UCSD-Quadcopter-Class/quad-hardware-connie/PartList.xlsx

Description | DATASHEET | DIST | DISTPN | MFR | MPN | VALUE | Lab02
Light emitting diode | http://media.digikey.com/pdf/Data%20Sheets/Lite-On%20PDFs/LTST-C170EKT.pdf | Digikey | 160-1178-1-ND | Lite-On Inc | LTST-C170EKT | red | you build
Light emitting diode | http://media.digikey.com/pdf/Data%20Sheets/Lite-On%20PDFs/LTST-C170GKT.pdf | Digikey | 160-1179-1-ND | Lite-On Inc | LTST-C170GKT | green
0805 0Ohm resistor | http://media.digikey.com/pdf/Data%20Sheets/Yageo%20PDFs/RC0805%20Pb%20Free.pdf | Digikey | 311-0.0ARCT-ND | Yageo | RC0805JR-070RL | 0 | you build
0805 100Ohm resistor | http://media.digikey.com/pdf/Data%20Sheets/Yageo%20PDFs/RC0805%20Pb%20Free.pdf | Digikey | 311-100ARCT-ND | Yageo | RC0805JR-07100RL | 100
0805 10KOhm resistor | http://media.digikey.com/pdf/Data%20Sheets/Yageo%20PDFs/RC0805%20Pb%20Free.pdf | Digikey | 311-10KARCT-ND | Yageo | RC0805JR-0710KL | 10K
0805 330Ohm resistor | http://media.digikey.com/pdf/Data%20Sheets/Yageo%20PDFs/RC0805%20Pb%20Free.pdf | Digikey | 311-330ARCT-ND | Yageo | RC0805JR-07330RL | 330
0805 5.1KOhm resistor | http://media.digikey.com/pdf/Data%20Sheets/Yageo%20PDFs/RC0805%20Pb%20Free.pdf | Digikey | 311-5.1KARCT-ND | Yageo | RC0805JR-075K1L | 5.1K
2x1 0.1" male header | http://multimedia.3m.com/mws/mediawebserver?66666UuZjcFSLXTtNxTElX&VEVuQEcuZgVs6EVs6E666666-- | Digikey | 3M9447-ND | 3M | 961102-6404-AR |  | Provided
Tactile buttons | http://www.te.com/commerce/DocumentDelivery/DDEController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 | Digikey | 450-1759-1-ND | TE Connectivity Alcoswitch Switches | FSM4JSMA
100uF Tantalum Capacitor | http://datasheets.avx.com/TAJ.pdf | Digikey | 478-1677-1-ND | AVX Corporation | TAJB107K006RNJ | 100uF
220uF Tantalum Capacitor | http://datasheets.avx.com/TAJ.pdf | Digikey | 478-8912-1-ND | AVX Corporation | TAJD227K006RNJ | 220uF
0.1uF Ceramic Capacitor | http://www.murata.com/~/media/webrenewal/support/library/catalog/products/capacitor/mlcc/c02e.ashx | Digikey | 490-1666-1-ND | Murata Electronics North America | GRM21BR71H104KA01L | 0.1uF | Provided
0.22uF Ceramic Capacitor | http://www.murata.com/~/media/webrenewal/support/library/catalog/products/capacitor/mlcc/c02e.ashx | Digikey | 490-1670-1-ND | Murata Electronics North America | GRM21BR71H224KA01L | 0.22uF
4.7uF Ceramic Capacitor | http://www.murata.com/~/media/webrenewal/support/library/catalog/products/capacitor/mlcc/c02e.ashx | Digikey | 490-3335-1-ND | Murata Electronics North America | GRM21BR61E475KA12L | 4.7uF
0.75pF Ceramic Capacitor | http://search.murata.co.jp/Ceramy/image/img/A01X/G101/ENG/GQM2195C2AR75CB01-01.pdf | Digikey | 490-3585-1-ND | Murata Electronics North America | GQM2195C2AR75CB01D | 0.75pF
1uF Ceramic Capacitor | http://www.murata.com/~/media/webrenewal/support/library/catalog/products/capacitor/mlcc/c02e.ashx | Digikey | 490-4736-1-ND | Murata Electronics North America | GRM21BR71H105KA12L | 1uF
10uF Ceramic Capacitor | http://www.murata.com/~/media/webrenewal/support/library/catalog/products/capacitor/mlcc/c02e.ashx | Digikey | 490-5523-1-ND | Murata Electronics North America | GRM21BR61E106KA73L | 10uF
12pF Ceramic Capacitor | http://www.murata.com/~/media/webrenewal/support/library/catalog/products/capacitor/mlcc/c02e.ashx | Digikey | 490-5531-1-ND | Murata Electronics North America | GRM21A5C2E120JW01D | 12pF
22pF Ceramic Capacitor | http://www.murata.com/~/media/webrenewal/support/library/catalog/products/capacitor/mlcc/c02e.ashx | Digikey | 490-5534-1-ND | Murata Electronics North America | GRM21A5C2E220JW01D | 22pF
0.01uF Ceramic Capacitor | http://www.murata.com/~/media/webrenewal/support/library/catalog/products/capacitor/mlcc/c02e.ashx | Digikey | 490-8295-1-ND | Murata Electronics North America | GRM2195C1H103FA01D | 0.01uF
LSM9DS1TR 9-Axis IMU | http://www.st.com/content/ccc/resource/technical/document/datasheet/1e/3f/2a/d6/25/eb/48/46/DM00103319.pdf/files/DM00103319.pdf/jcr:content/translations/en.DM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 | Digikey | 497-14946-1-ND | STMicroelectronics | LSM9DS1TR |  | you build
12pF Ceramic Capacitor | http://www.abracon.com/Resonators/abm3b.pdf | Digikey | 535-9122-1-ND | Abracon LLC | ABM3B-16.000MHZ-B2-T
2x3 0.1" male header | http://portal.fciconnect.com/Comergent//fci/drawing/67996.pdf | Digikey | 609-3234-ND | Amphenol FCI | 67997-206HLF
1x10 0.1" pin male header | http://portal.fciconnect.com/Comergent//fci/drawing/68000.pdf | Digikey | 609-3250-ND | Amphenol FCI | 68000-110HLF
1x6 0.1" right handle male header | http://portal.fciconnect.com/Comergent//fci/drawing/68015.pdf | Digikey | 609-3327-ND | Amphenol FCI | 68016-406HLF
0805 Balun | http://katalog.we-online.de/pbs/datasheet/748421245.pdf | Digikey | 732-2230-6-ND | Wurth Electronics Inc | 748421245
Chip antenna | http://www.linxtechnologies.com/resources/data-guides/ant-xxx-chp-x.pdf | Digikey | ANT-2.45-CHPCT-ND | Linx Technologies Inc. | ANT-2.45-CHP-T
ATmega128RFA1 Microcontroller | http://www.atmel.com/Images/Atmel-8266-MCU_Wireless-ATmega128RFA1_Datasheet.pdf | Digikey | ATMEGA128RFA1-ZU00-ND | Atmel | ATMEGA128RFA1-ZUR00
SOD-123 Schottky diode | http://toshiba.semicon-storage.com/info/docget.jsp?did=3168&prodName=CRS08 | Digikey | CRS08QMCT-ND | Toshiba Semiconductor and Storage | CRS08(TE85L,Q,M) | 360mV
3.0V Voltage Regulator | http://www.ti.com/lit/ds/symlink/lp3985.pdf | Digikey | LP3985IM5X-3.0/NOPBCT-ND | Texas Instruments | LP3985IM5X-3.0/NOPB
N-Channel MOSFET | http://www.vishay.com/docs/68645/si2302cds.pdf | Digikey | SI2302CDS-T1-E3CT-ND | Vishay Siliconix | SI2302CDS-T1-E3 | 2.6A | you build
Battery holder | See replacement body in crash kit
Motor connector | 2 SMDs (one negative, one positive) 2-3mm on a side 2 mm between them.
