UCSD-Quadcopter-Class/quad-hardware-connie/quadcopter.brd

## EAGLE design quadcopter.brd (2017-05-19)

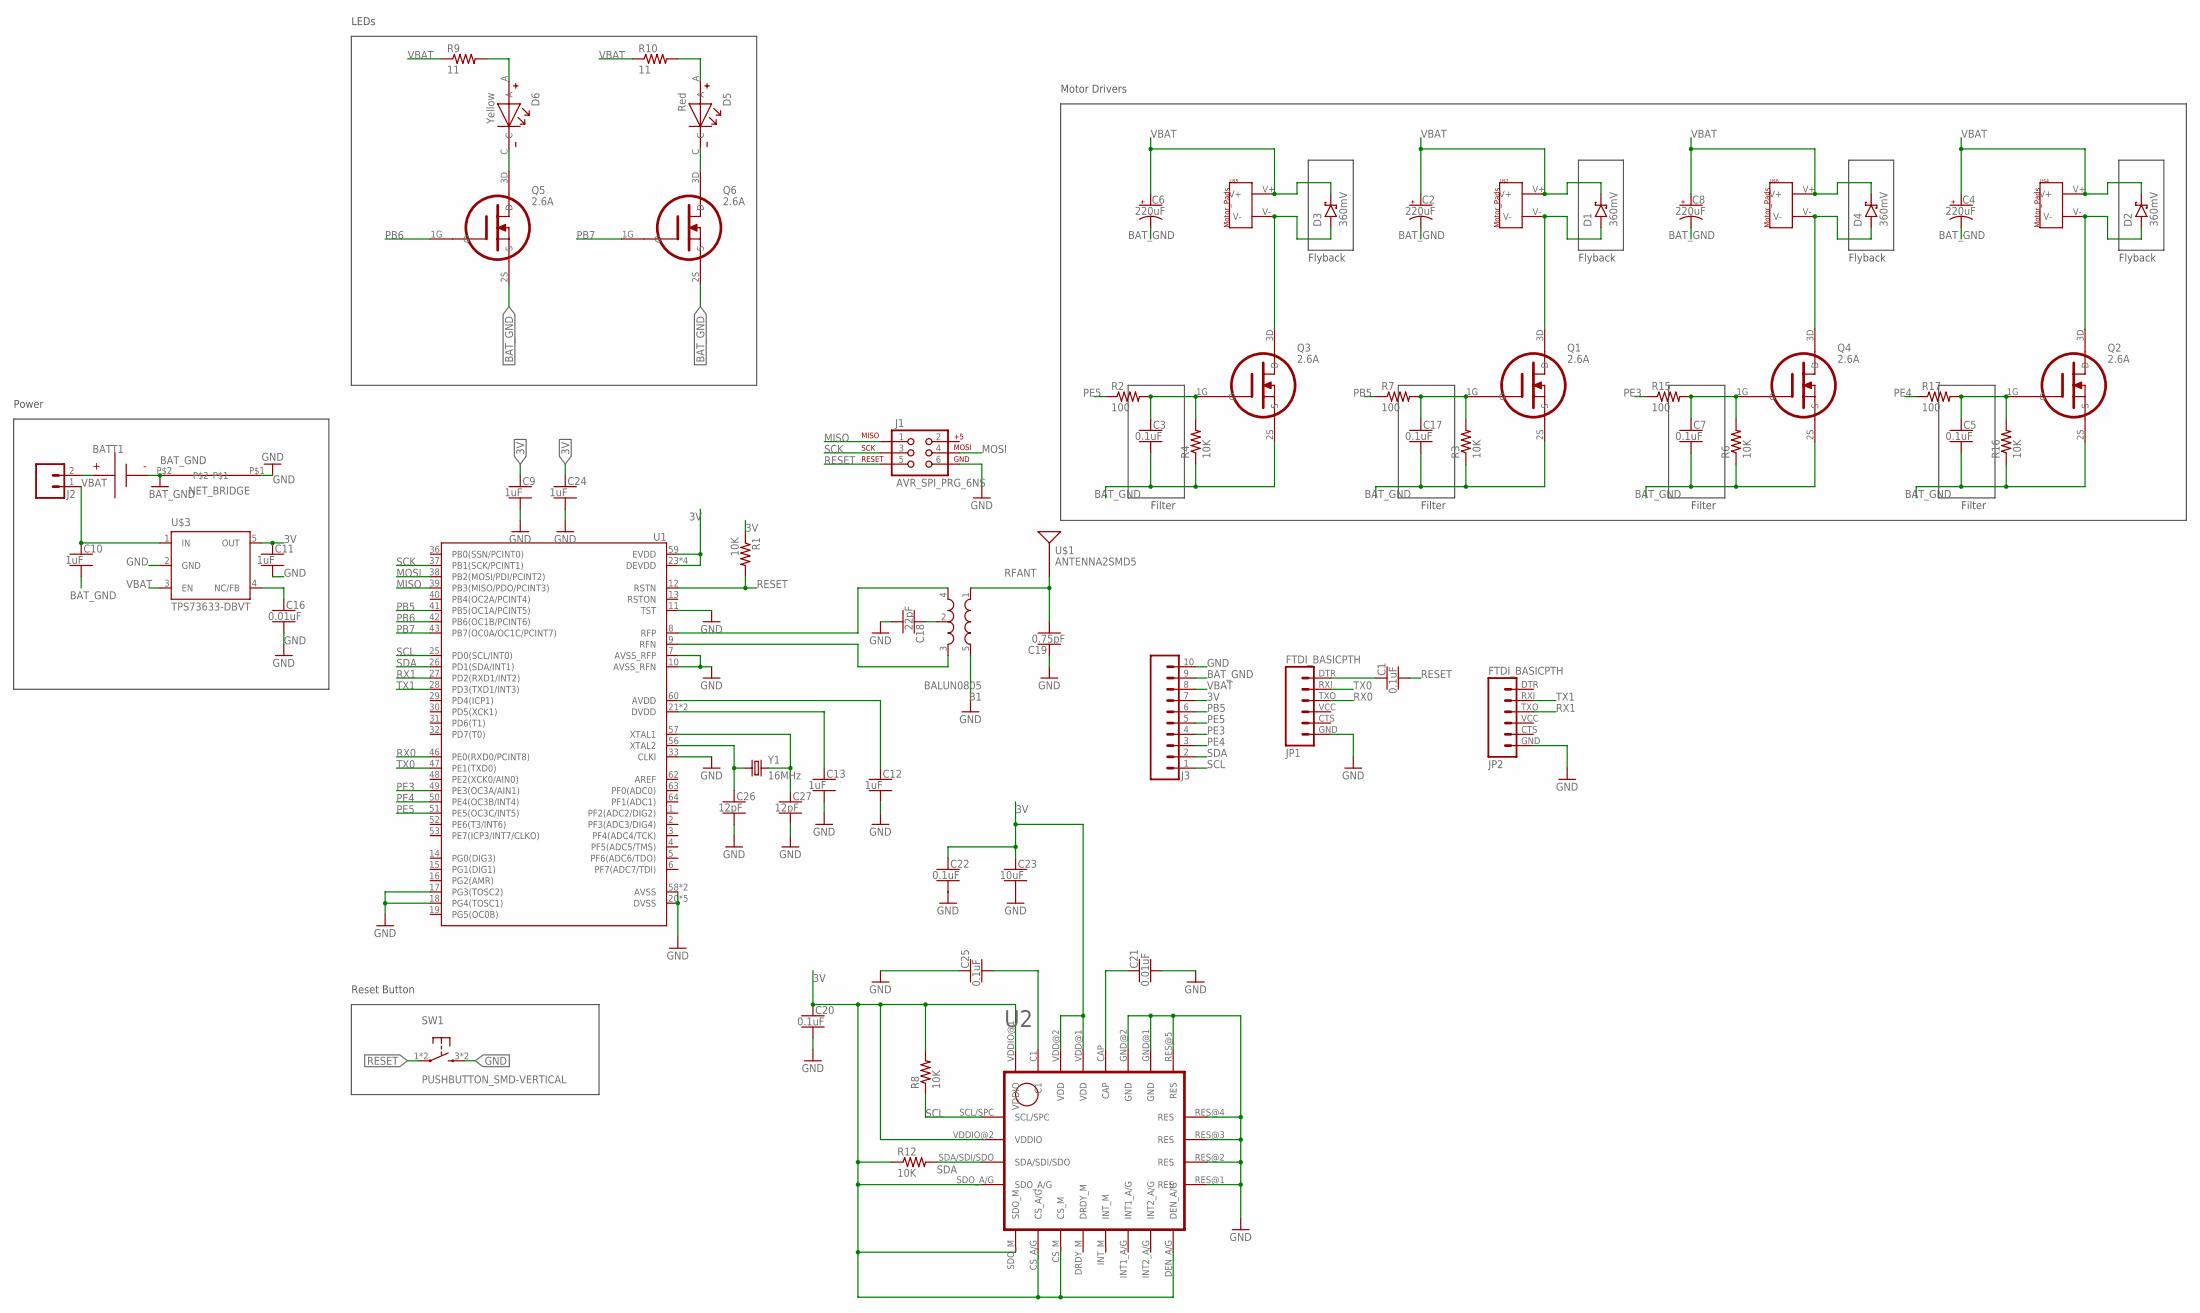
[picture p1: schematic quadcopter.sch]

Parts:
B1: BALUN0805; BALUN
BATT1: BATTERY-HUBSAN-W/HOLDER; BATTERY-W/HOLDER-380MAH-HUBSAN
C1: 0.1uF; CERAMIC_CAP_0805
C2, C4, C6, C8: 220uF; CAPMP7343X310_HS
C3, C5, C7, C17, C20, C22, C25: 0.1uF; CAPC2012X140_HS
C9, C10, C11, C12, C13, C24: 1uF; CAPC2012X140_HS
C16, C21: 0.01uF; CAPC2012X140_HS
C18: 22pF; CAPC2012X140_HS
C19: 0.75pF; CAPC2012X140_HS
C23: 10uF; CAPC2012X140_HS
C26, C27: 12pF; CAPC2012X140_HS
D1, D2, D3, D4: 360mV; SOD3716X135_HS
D5: Red; LED_VLMX51Z1AA
D6: Yellow; LED_VLMX51Z1AA
J1: AVR_SPI_PRG_6NS; 2X3-NS
J2: MALE_HEADER_2POS-2X1-0.1IN; MALE_HEADER_2X1_0.1IN
J3: SIP-10_TH-254X10; HDRV10W63P254_10X1_2540X254H838_HS
JP1, JP2: FTDI_BASICPTH; FTDI_BASIC
NET_BRIDGE: NET_BRIDGE
Q1, Q2, Q3, Q4, Q5, Q6: 2.6A; N_MOSFET_SI2302CDS_T1_E3
R1, R3, R4, R6, R8, R12, R16: 10K; RESC2012X60_HS
R2, R7, R15, R17: 100; RESC2012X60_HS
R9, R10: 11; RESC2012X60_HS
SW1: PUSHBUTTON_SMD-VERTICAL; TE_FSM8JSMA_HS
U1: ATMEGA128RFA1; QFN-64
U2: IMU_LSM9DS1TR
U$1: ANTENNA2SMD5; ANTENNA-CHIP5
U$2, U$4, U$5, U$6: MOTOR_PADS
U$3: TPS73633-DBVT; SOT23-DBV
Y1: 16MHz; CRYSTAL-SMD-5X3

Connections:
3V: C9.1, C11.1, C20.1, C22.1, C23.1, C24.1, J3.7, R1.1, R8.2, R12.1, U1.23 (DEVDD), U1.34 (DEVDD), U1.44 (DEVDD), U1.54 (DEVDD), U1.59 (EVDD), U2.CS_A/G, U2.CS_M, U2.DEN_A/G, U2.SDO_A/G, U2.SDO_M, U2.VDD@1 (VDD), U2.VDD@2 (VDD), U2.VDDIO@1 (VDDIO), U2.VDDIO@2 (VDDIO), U$3.5 (OUT)
BAT_GND: BATT1.- (N), C2.2 (-), C3.2, C4.2 (-), C5.2, C6.2 (-), C7.2, C8.2 (-), C10.2, C17.2, J3.9, NET_BRIDGE.P$2, Q1.2S (S), Q2.2S (S), Q3.2S (S), Q4.2S (S), Q5.2S (S), Q6.2S (S), R3.1, R4.1, R6.1, R16.1
FILTERED: C7.1, Q4.1G (G), R6.2, R15.2
GND: B1.5 (GND), C9.2, C11.2, C12.2, C13.2, C16.2, C18.2, C19.1, C20.2, C21.2, C22.2, C23.2, C24.2, C25.1, C26.2, C27.2, J1.6, J3.10, JP1.GND (6), JP2.GND (6), NET_BRIDGE.P$1, SW1.3 (2), SW1.4 (2), U1.7 (AVSS_RFP), U1.10 (AVSS_RFN), U1.11 (TST), U1.17 (PG3(TOSC2)), U1.18 (PG4(TOSC1)), U1.20 (DVSS), U1.24 (DVSS), U1.33 (CLKI), U1.35 (DVSS), U1.45 (DVSS), U1.55 (DVSS), U1.58 (AVSS), U1.61 (AVSS), U2.GND@1 (GND), U2.GND@2 (GND), U2.RES@1 (RES), U2.RES@2 (RES), U2.RES@3 (RES), U2.RES@4 (RES), U2.RES@5 (RES), U$3.2 (GND)
MISO: J1.1, U1.39 (PB3(MISO/PDO/PCINT3))
MOSI: J1.4, U1.38 (PB2(MOSI/PDI/PCINT2))
unnamed: C1.1, JP1.DTR (1)
unnamed: D6.C, Q5.3D (D)
unnamed: D6.A, R9.2
unnamed: D5.C, Q6.3D (D)
unnamed: C27.1, U1.57 (XTAL1), Y1.3 (2)
unnamed: D5.A, R10.2
unnamed: C12.1, U1.60 (AVDD)
unnamed: C13.1, U1.21 (DVDD), U1.22 (DVDD)
unnamed: C26.1, U1.56 (XTAL2), Y1.1
unnamed: C25.2, U2.C1
unnamed: D1.A, Q1.3D (D), U$2.V-
unnamed: C21.1, U2.CAP
unnamed: B1.4 (OUT1), U1.8 (RFP)
unnamed: B1.3 (OUT2), U1.9 (RFN)
unnamed: BATT1.+, J2.2
unnamed: D3.A, Q3.3D (D), U$5.V-
unnamed: B1.2 (GND), C18.1
unnamed: D4.A, Q4.3D (D), U$6.V-
unnamed: D2.A, Q2.3D (D), U$4.V-
unnamed: C3.1, Q3.1G (G), R2.2, R4.2
unnamed: C16.1, U$3.4 (NC/FB)
unnamed: C17.1, Q1.1G (G), R3.2, R7.2
unnamed: C5.1, Q2.1G (G), R16.2, R17.2
PB5: J3.6, R7.1, U1.41 (PB5(OC1A/PCINT5))
PB6: Q5.1G (G), U1.42 (PB6(OC1B/PCINT6))
PB7: Q6.1G (G), U1.43 (PB7(OC0A/OC1C/PCINT7))
PE3: J3.4, R15.1, U1.49 (PE3(OC3A/AIN1))
PE4: J3.3, R17.1, U1.50 (PE4(OC3B/INT4))
PE5: J3.5, R2.1, U1.51 (PE5(OC3C/INT5))
RESET: C1.2, J1.5, R1.2, SW1.1, SW1.2 (1), U1.12 (RSTN)
RFANT: B1.1 (IN), C19.2, U$1.FEED
RX0: JP1.TXO (3), U1.46 (PE0(RXD0/PCINT8))
RX1: JP2.TXO (3), U1.27 (PD2(RXD1/INT2))
SCK: J1.3, U1.37 (PB1(SCK/PCINT1))
SCL: J3.1, R8.1, U1.25 (PD0(SCL/INT0)), U2.SCL/SPC
SDA: J3.2, R12.2, U1.26 (PD1(SDA/INT1)), U2.SDA/SDI/SDO
TX0: JP1.RXI (2), U1.47 (PE1(TXD0))
TX1: JP2.RXI (2), U1.28 (PD3(TXD1/INT3))
VBAT: C2.1 (+), C4.1 (+), C6.1 (+), C8.1 (+), C10.1, D1.C, D2.C, D3.C, D4.C, J2.1, J3.8, R9.1, R10.1, U$2.V+, U$3.1 (IN), U$3.3 (EN), U$4.V+, U$5.V+, U$6.V+

Notes on the sheet:
Flyback
Filter
Reset Button
LEDs
Motor Drivers
Power

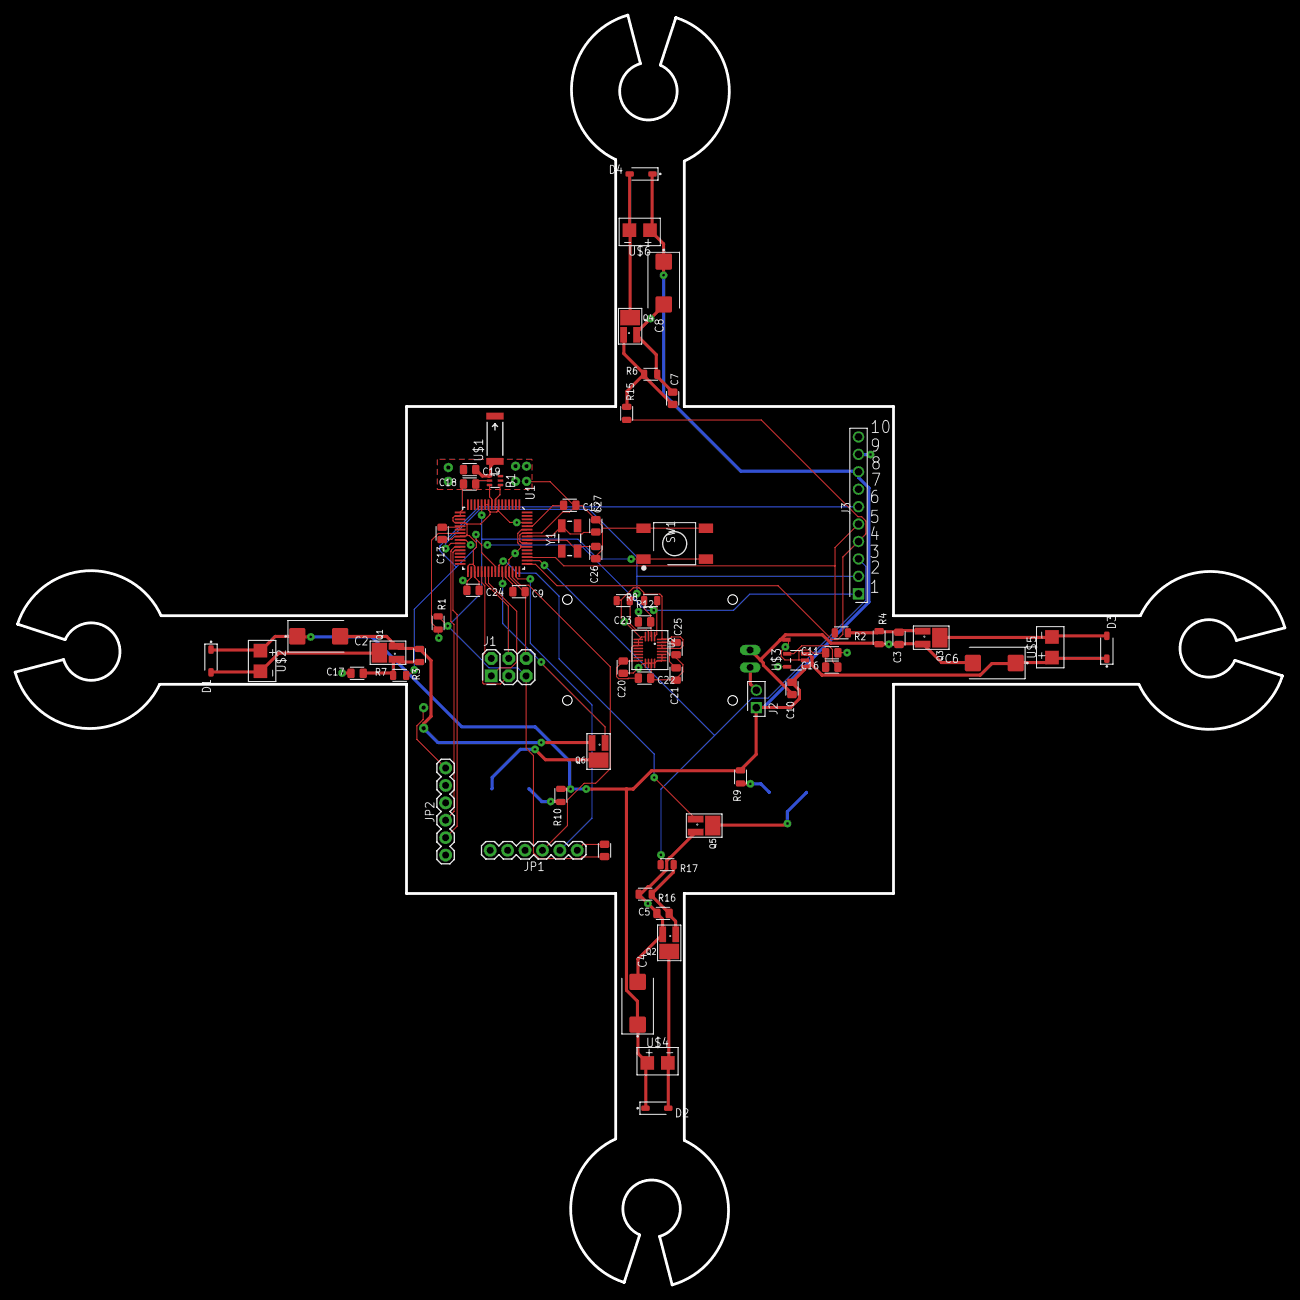
[picture p2: board quadcopter.brd from above]

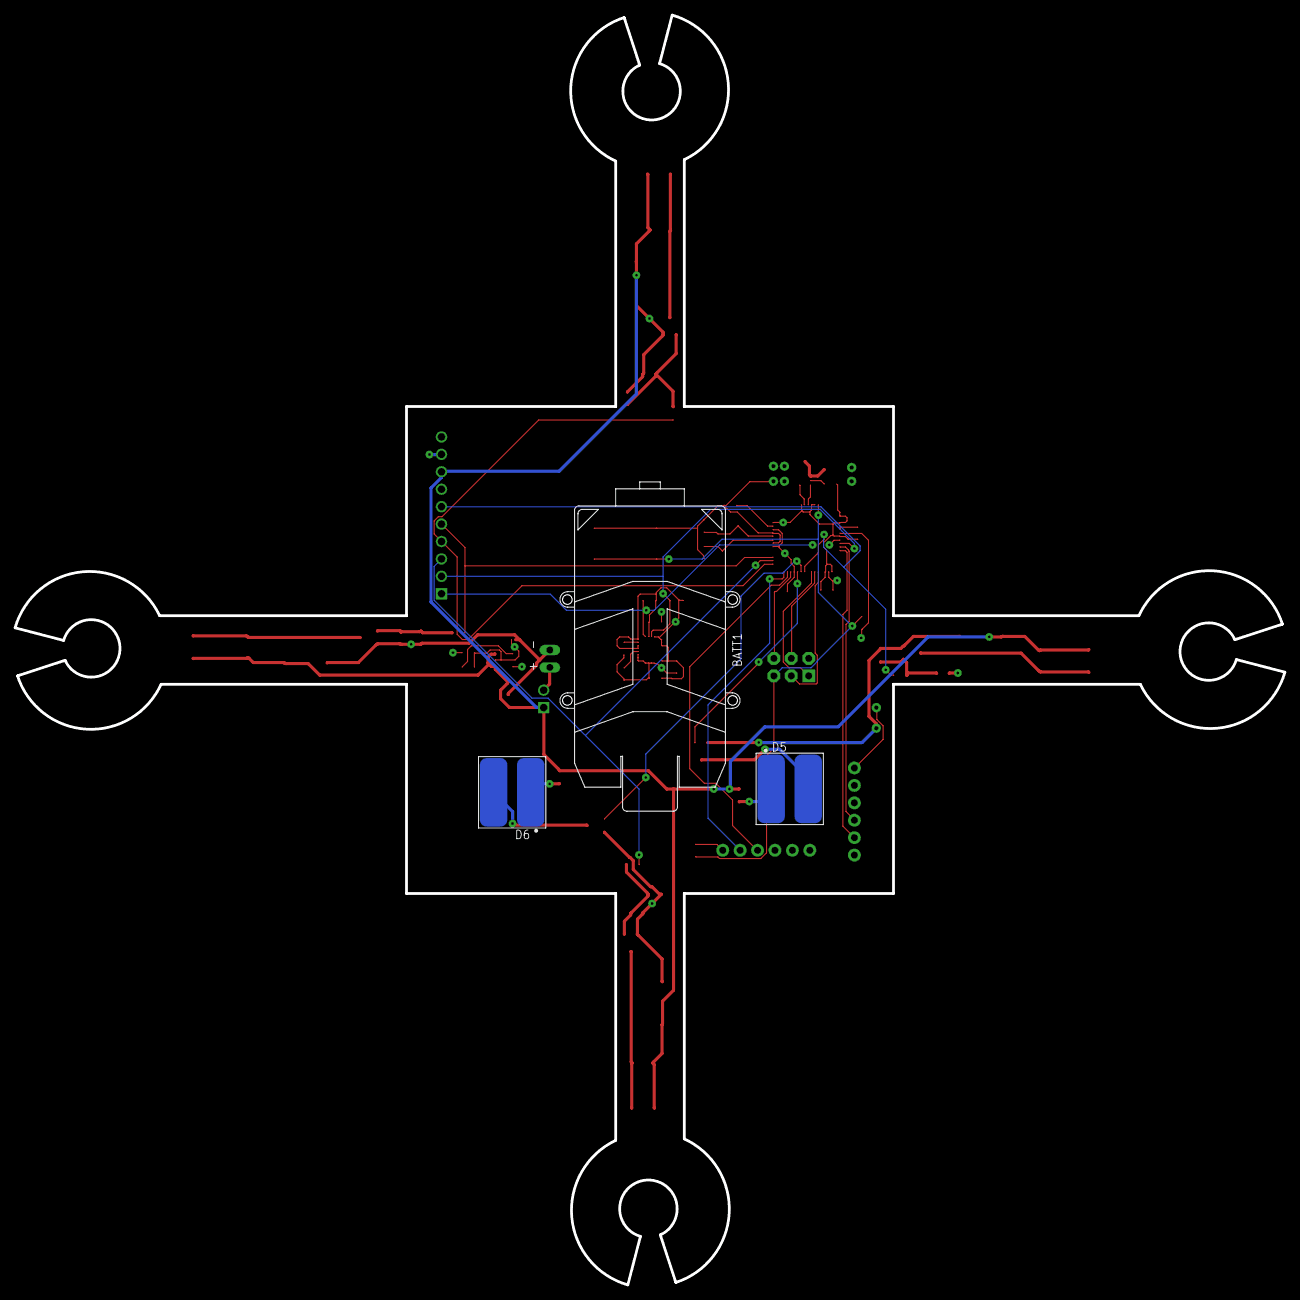
[picture p3: board quadcopter.brd from below]

Board: 4 copper layers, 185.1 x 185.1 mm, 68 parts (3 on the bottom side), 45 nets.
