UCSD-Quadcopter-Class/quad-hardware-connie/ATmega128RFA1_Dev-master/Production Files/ATmega128RFA1-DevBoard-Panel-v23.brd

## EAGLE design ATmega128RFA1_Dev-master/Production Files/ATmega128RFA1-DevBoard-Panel-v23.brd (2017-04-18)

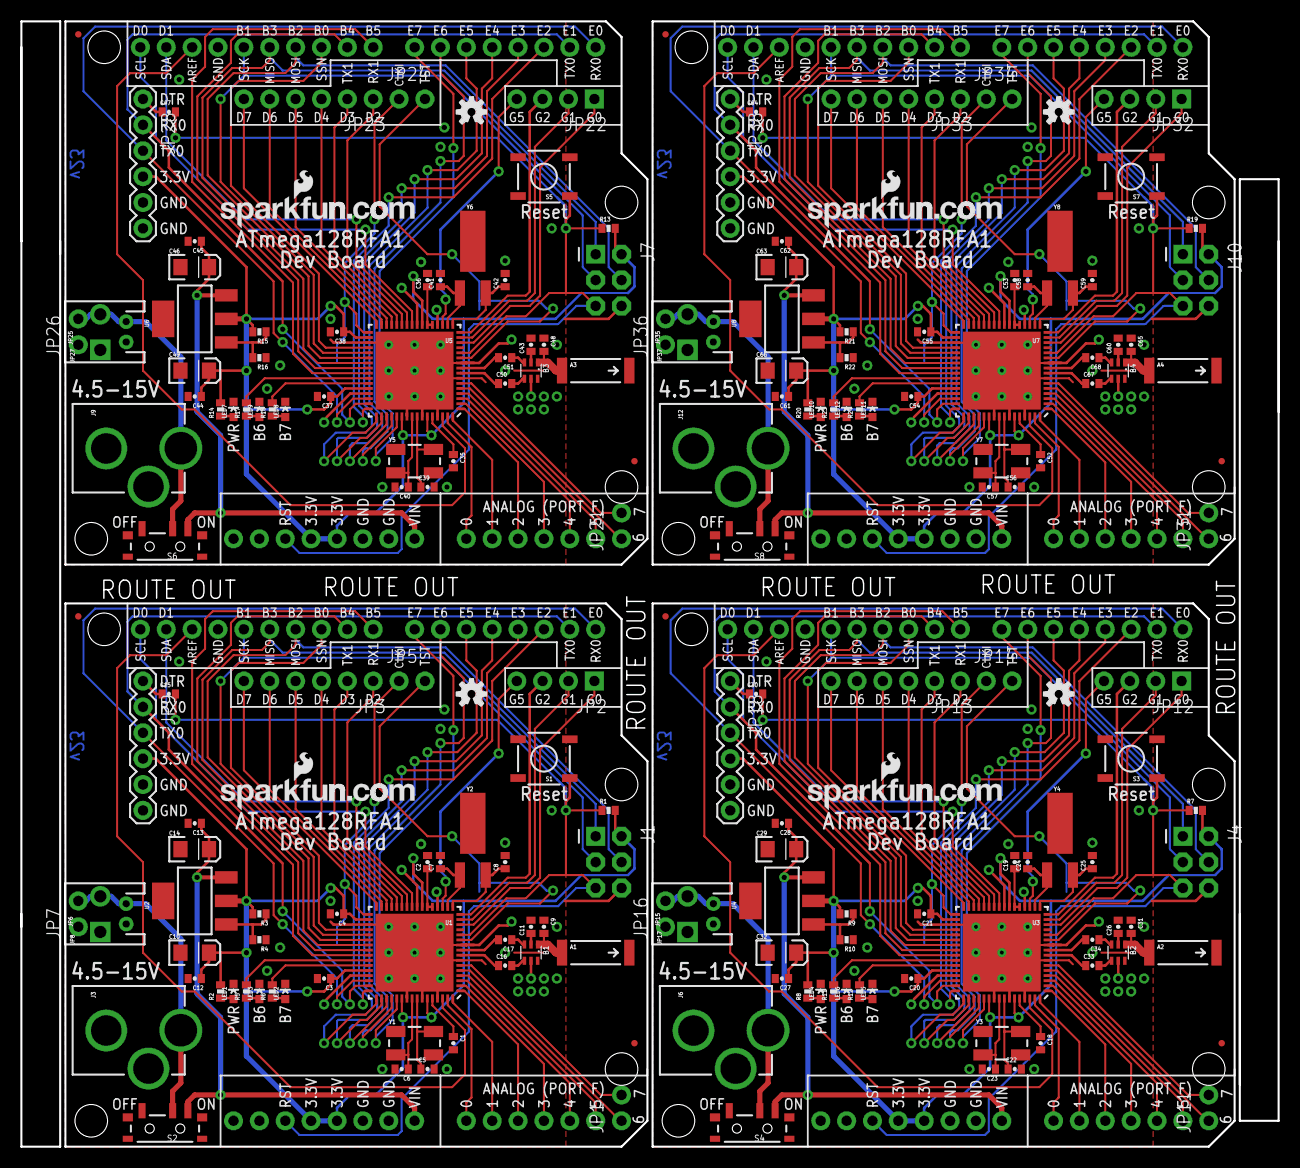
[picture p7: board ATmega128RFA1-DevBoard-Panel-v23.brd from above]

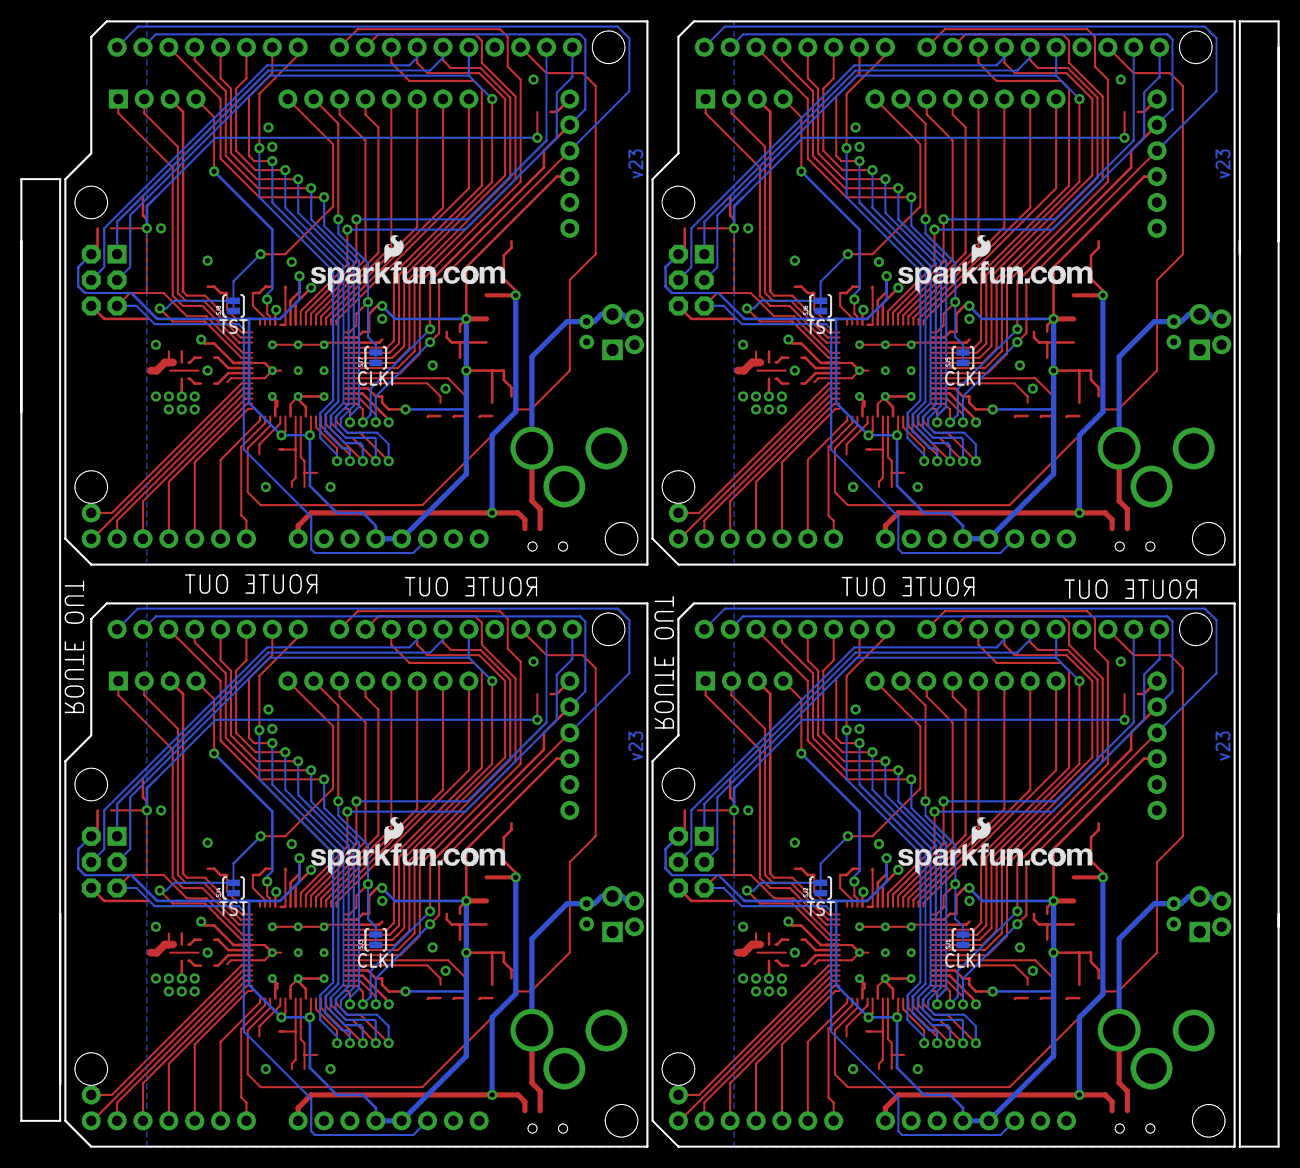
[picture p8: board ATmega128RFA1-DevBoard-Panel-v23.brd from below]

Board: 2 copper layers, 123.4 x 110.5 mm, 208 parts (12 on the bottom side), 244 nets.

Parts:
A1, A2, A3, A4: ANTENNA2SMD5; ANTENNA-CHIP5
B1, B2, B3, B4: 748421245; BALUN
C1, C2, C3, C4, C12, C18, C19, C20, C21, C27, C35, C36, C37, C38, C44, C52, C53, C54, C55, C61: 1uF; 0402-CAP
C5, C6, C7, C8, C22, C23, C24, C25, C39, C40, C41, C42, C56, C57, C58, C59: 12pF; 0402-CAP
C9, C31, C48, C65: 0.75pF; 0402-CAP
C10, C14, C29, C32, C46, C49, C63, C66: 10uF; EIA3216
C11, C26, C43, C60: 22pF; 0402-CAP
C13, C15, C28, C30, C45, C47, C62, C64: 0.1uF; 0402-CAP
C16, C17, C33, C34, C50, C51, C67, C68: JUMP; 0402-CAP
FID1, FID2, FID3, FID4, FID5, FID6, FID7, FID8: FIDUCIALUFIDUCIAL; MICRO-FIDUCIAL
J1, J4, J7, J10: ISP; 2X3-NS
J2, J5, J8, J11: ARDUINO_UNO_R3
J3, J6, J9, J12: POWER_JACKPTH_LOCK; POWER_JACK_PTH_LOCK
JP1, JP5, JP7, JP11, JP14, JP16, JP21, JP24, JP26, JP31, JP34, JP36: 1X02_NO_SILK
JP2, JP12, JP22, JP32: 1X04_NO_SILK
JP3, JP13, JP23, JP33: 1X06_NS
JP4, JP10, JP19, JP20, JP29, JP30, JP39, JP40: LOGO-SFENEW; SFE-NEW-WEBLOGO
JP6, JP15, JP25, JP35: JST-2-PTH
JP8, JP17, JP27, JP37: SCREWTERMINAL-3.5MM-2-NS
JP9, JP18, JP28, JP38: FTDI; FTDI_BASIC
LED1, LED4, LED7, LED10: RED; LED-0603
LED2, LED3, LED5, LED6, LED8, LED9, LED11, LED12: GREEN; LED-0603
R1, R7, R13, R19: 10k; 0402-RES
R2, R8, R14, R20: 1k; 0402-RES
R3, R9, R15, R21: 240; 0402-RES
R4, R10, R16, R22: 390; 0402-RES
R5, R6, R11, R12, R17, R18, R23, R24: 330; 0402-RES
S1, S3, S5, S7: TACTILE_SWITCH_SMD
S2, S4, S6, S8: SWITCH-SPST-SMD-A
SJ1, SJ2, SJ3, SJ4, SJ5, SJ6, SJ7, SJ8: SJ_2S-TRACE
U1, U3, U5, U7: ATMEGA128RFA1; QFN-64
U2, U4, U6, U8: LM1117; SOT223
U$1, U$2, U$3, U$4: OSHW-LOGOS; OSHW-LOGO-S
Y1, Y3, Y5, Y7: 16MHz; CRYSTAL-SMD-5X3
Y2, Y4, Y6, Y8: 32.768kHz; CRYSTAL-32KHZ-SMD

Connections:
3.3V: C3.1, C4.1, C10.A, C12.1, J1.2, J2.3.3V, J2.5V, JP9.VCC, R1.2, R2.2, R3.2, U1.23, U1.34, U1.44, U1.54, U1.59, U2.2
3.3V1: C20.1, C21.1, C27.1, C32.A, J4.2, J5.3.3V, J5.5V, JP18.VCC, R7.2, R8.2, R9.2, U3.23, U3.34, U3.44, U3.54, U3.59, U4.2
3.3V2: C37.1, C38.1, C44.1, C49.A, J7.2, J8.3.3V, J8.5V, JP28.VCC, R13.2, R14.2, R15.2, U5.23, U5.34, U5.44, U5.54, U5.59, U6.2
3.3V3: C54.1, C55.1, C61.1, C66.A, J10.2, J11.3.3V, J11.5V, JP38.VCC, R19.2, R20.2, R21.2, U7.23, U7.34, U7.44, U7.54, U7.59, U8.2
A0: J2.A0, U1.63
A1: J2.A1, U1.64
A2: J2.A2, U1.1
A3: J2.A3, U1.2
A4: J2.A4, U1.3
A5: J2.A5, U1.4
A6: JP1.1, U1.5
A7: JP1.2, U1.6
A8: J5.A0, U3.63
A9: J5.A1, U3.64
A10: J5.A2, U3.1
A11: J5.A3, U3.2
A12: J5.A4, U3.3
A13: J5.A5, U3.4
A14: JP11.1, U3.5
A15: JP11.2, U3.6
A16: J8.A0, U5.63
A17: J8.A1, U5.64
A18: J8.A2, U5.1
A19: J8.A3, U5.2
A20: J8.A4, U5.3
A21: J8.A5, U5.4
A22: JP21.1, U5.5
A23: JP21.2, U5.6
A24: J11.A0, U7.63
A25: J11.A1, U7.64
A26: J11.A2, U7.1
A27: J11.A3, U7.2
A28: J11.A4, U7.3
A29: J11.A5, U7.4
A30: JP31.1, U7.5
A31: JP31.2, U7.6
AREF: J2.AREF, U1.62
AREF1: J5.AREF, U3.62
AREF2: J8.AREF, U5.62
AREF3: J11.AREF, U7.62
AVDD: C1.1, U1.60
AVDD1: C18.1, U3.60
AVDD2: C35.1, U5.60
AVDD3: C52.1, U7.60
CLKI: JP5.1, SJ1.2, U1.33
CLKI1: JP14.1, SJ3.2, U3.33
CLKI2: JP24.1, SJ5.2, U5.33
CLKI3: JP34.1, SJ7.2, U7.33
DTR: C15.1, JP9.DTR
DTR1: C30.1, JP18.DTR
DTR2: C47.1, JP28.DTR
DTR3: C64.1, JP38.DTR
DVDD: C2.1, U1.21, U1.22
DVDD1: C19.1, U3.21, U3.22
DVDD2: C36.1, U5.21, U5.22
DVDD3: C53.1, U7.21, U7.22
FB: R3.1, R4.2, U2.1
FB1: R9.1, R10.2, U4.1
FB2: R15.1, R16.2, U6.1
FB3: R21.1, R22.2, U8.1
GND: B1.5, C1.2, C2.2, C3.2, C4.2, C5.2, C6.2, C7.2, C8.2, C9.1, C10.C, C11.2, C12.2, C13.2, C14.C, J1.6, J2.GND@0, J2.GND@1, J2.GND@2, J3.GND, J3.GNDBREAK, JP6.1, JP7.1, JP8.1, JP9.GND, LED1.C, LED2.C, LED3.C, R4.1, S1.3, SJ1.1, SJ2.1, U1.7, U1.10, U1.20, U1.24, U1.35, U1.45, U1.55, U1.58, U1.61, U1.65
GND1: B2.5, C18.2, C19.2, C20.2, C21.2, C22.2, C23.2, C24.2, C25.2, C26.2, C27.2, C28.2, C29.C, C31.1, C32.C, J4.6, J5.GND@0, J5.GND@1, J5.GND@2, J6.GND, J6.GNDBREAK, JP15.1, JP16.1, JP17.1, JP18.GND, LED4.C, LED5.C, LED6.C, R10.1, S3.3, SJ3.1, SJ4.1, U3.7, U3.10, U3.20, U3.24, U3.35, U3.45, U3.55, U3.58, U3.61, U3.65
GND2: B3.5, C35.2, C36.2, C37.2, C38.2, C39.2, C40.2, C41.2, C42.2, C43.2, C44.2, C45.2, C46.C, C48.1, C49.C, J7.6, J8.GND@0, J8.GND@1, J8.GND@2, J9.GND, J9.GNDBREAK, JP25.1, JP26.1, JP27.1, JP28.GND, LED7.C, LED8.C, LED9.C, R16.1, S5.3, SJ5.1, SJ6.1, U5.7, U5.10, U5.20, U5.24, U5.35, U5.45, U5.55, U5.58, U5.61, U5.65
GND3: B4.5, C52.2, C53.2, C54.2, C55.2, C56.2, C57.2, C58.2, C59.2, C60.2, C61.2, C62.2, C63.C, C65.1, C66.C, J10.6, J11.GND@0, J11.GND@1, J11.GND@2, J12.GND, J12.GNDBREAK, JP35.1, JP36.1, JP37.1, JP38.GND, LED10.C, LED11.C, LED12.C, R22.1, S7.3, SJ7.1, SJ8.1, U7.7, U7.10, U7.20, U7.24, U7.35, U7.45, U7.55, U7.58, U7.61, U7.65
MISO: J1.1, J2.D12, U1.39
MISO1: J4.1, J5.D12, U3.39
MISO2: J7.1, J8.D12, U5.39
MISO3: J10.1, J11.D12, U7.39
MOSI: J1.4, J2.D11, U1.38
MOSI1: J4.4, J5.D11, U3.38
MOSI2: J7.4, J8.D11, U5.38
MOSI3: J10.4, J11.D11, U7.38
unnamed: C22.1, U3.57, Y3.3
unnamed: LED1.A, R2.1
unnamed: C5.1, U1.57, Y1.3
unnamed: C6.1, U1.56, Y1.1
unnamed: C7.1, U1.18, Y2.X1
unnamed: C8.1, U1.17, Y2.X2
unnamed: B1.2, C11.1
unnamed: LED3.A, R5.1
unnamed: J3.PWR, JP6.2, JP7.2, JP8.2, S2.2
unnamed: B1.4, C16.2
unnamed: B1.3, C17.1
unnamed: C23.1, U3.56, Y3.1
unnamed: LED2.A, R6.1
unnamed: C24.1, U3.18, Y4.X1
unnamed: C25.1, U3.17, Y4.X2
unnamed: LED4.A, R8.1
unnamed: B2.2, C26.1
unnamed: B2.4, C33.2
unnamed: B2.3, C34.1
unnamed: LED6.A, R11.1
unnamed: LED5.A, R12.1
unnamed: J6.PWR, JP15.2, JP16.2, JP17.2, S4.2
unnamed: C39.1, U5.57, Y5.3
unnamed: C40.1, U5.56, Y5.1
unnamed: C41.1, U5.18, Y6.X1
unnamed: C42.1, U5.17, Y6.X2
unnamed: LED7.A, R14.1
unnamed: B3.2, C43.1
unnamed: B3.4, C50.2
unnamed: B3.3, C51.1
unnamed: LED9.A, R17.1
unnamed: LED8.A, R18.1
unnamed: J9.PWR, JP25.2, JP26.2, JP27.2, S6.2
unnamed: C56.1, U7.57, Y7.3
unnamed: C57.1, U7.56, Y7.1
unnamed: C58.1, U7.18, Y8.X1
unnamed: C59.1, U7.17, Y8.X2
unnamed: LED10.A, R20.1
unnamed: B4.2, C60.1
unnamed: B4.4, C67.2
unnamed: B4.3, C68.1
unnamed: LED12.A, R23.1
unnamed: LED11.A, R24.1
unnamed: J12.PWR, JP35.2, JP36.2, JP37.2, S8.2
PB1: R12.2, U3.43
PB2: R11.2, U3.42
PB3: J5.D8, U3.41
PB4: J2.D9, U1.40
PB5: J2.D8, U1.41
PB6: R5.2, U1.42
PB7: R6.2, U1.43
PB8: J5.D9, U3.40
PB9: R18.2, U5.43
PB10: R17.2, U5.42
PB11: J8.D8, U5.41
PB12: J8.D9, U5.40
PB13: R24.2, U7.43
PB14: R23.2, U7.42
PB15: J11.D8, U7.41
PB16: J11.D9, U7.40
PD1: JP13.6, U3.32
PD2: JP13.5, U3.31
PD3: JP13.4, U3.30
PD4: JP3.3, U1.29
PD5: JP3.4, U1.30
PD6: JP3.5, U1.31
PD7: JP3.6, U1.32
PD8: JP13.3, U3.29
PD9: JP23.6, U5.32
PD10: JP23.5, U5.31
PD11: JP23.4, U5.30
PD12: JP23.3, U5.29
PD13: JP33.6, U7.32
PD14: JP33.5, U7.31
PD15: JP33.4, U7.30
PD16: JP33.3, U7.29
PE1: J5.D7, U3.53
PE2: J2.D2, U1.48
PE3: J2.D3, U1.49
PE4: J2.D4, U1.50
PE5: J2.D5, U1.51
PE6: J2.D6, U1.52
PE7: J2.D7, U1.53
PE8: J5.D6, U3.52
PE9: J5.D5, U3.51
PE10: J5.D4, U3.50
PE11: J5.D3, U3.49
PE12: J5.D2, U3.48
PE13: J8.D7, U5.53
PE14: J8.D6, U5.52
PE15: J8.D5, U5.51
PE16: J8.D4, U5.50
PE17: J8.D3, U5.49
PE18: J8.D2, U5.48
PE19: J11.D7, U7.53
PE20: J11.D6, U7.52
PE21: J11.D5, U7.51
PE22: J11.D4, U7.50
PE23: J11.D3, U7.49
PE24: J11.D2, U7.48
PG0: JP2.1, U1.14
PG1: JP2.2, U1.15
PG2: JP2.3, U1.16
PG3: JP12.4, U3.19
PG4: JP12.3, U3.16
PG5: JP2.4, U1.19
PG6: JP12.2, U3.15
PG7: JP12.1, U3.14
PG8: JP22.4, U5.19
PG9: JP22.3, U5.16
PG10: JP22.2, U5.15
PG11: JP22.1, U5.14
PG12: JP32.4, U7.19
PG13: JP32.3, U7.16
PG14: JP32.2, U7.15
PG15: JP32.1, U7.14
RESET: C15.2, J1.5, J2.RES, R1.1, S1.1, U1.12
RESET1: C30.2, J4.5, J5.RES, R7.1, S3.1, U3.12
RESET2: C47.2, J7.5, J8.RES, R13.1, S5.1, U5.12
RESET3: C64.2, J10.5, J11.RES, R19.1, S7.1, U7.12
RFANT: A1.FEED, B1.1, C9.2
RFANT1: A2.FEED, B2.1, C31.2
RFANT2: A3.FEED, B3.1, C48.2
RFANT3: A4.FEED, B4.1, C65.2
RFN: C17.2, U1.9
RFN1: C34.2, U3.9
RFN2: C51.2, U5.9
RFN3: C68.2, U7.9
RFP: C16.1, U1.8
RFP1: C33.1, U3.8
RFP2: C50.1, U5.8
RFP3: C67.1, U7.8
RX0: J2.RX, JP9.TXO, U1.46
RX1: JP3.1, U1.27
RX2: J5.RX, JP18.TXO, U3.46
RX3: JP13.1, U3.27
RX4: J8.RX, JP28.TXO, U5.46
RX5: JP23.1, U5.27
RX6: J11.RX, JP38.TXO, U7.46
RX7: JP33.1, U7.27
SCK: J1.3, J2.D13, U1.37
SCK1: J4.3, J5.D13, U3.37
SCK2: J7.3, J8.D13, U5.37
SCK3: J10.3, J11.D13, U7.37
SCL: J2.SCL, U1.25
SCL1: J5.SCL, U3.25
SCL2: J8.SCL, U5.25
SCL3: J11.SCL, U7.25
SDA: J2.SDA, U1.26
SDA1: J5.SDA, U3.26
SDA2: J8.SDA, U5.26
SDA3: J11.SDA, U7.26
SSN: J2.D10, U1.36
SSN1: J5.D10, U3.36
SSN2: J8.D10, U5.36
SSN3: J11.D10, U7.36
TST: JP5.2, SJ2.2, U1.11
TST1: JP14.2, SJ4.2, U3.11
TST2: JP24.2, SJ6.2, U5.11
TST3: JP34.2, SJ8.2, U7.11
TX0: J2.TX, JP9.RXI, U1.47
TX1: JP3.2, U1.28
TX2: J5.TX, JP18.RXI, U3.47
TX3: JP13.2, U3.28
TX4: J8.TX, JP28.RXI, U5.47
TX5: JP23.2, U5.28
TX6: J11.TX, JP38.RXI, U7.47
TX7: JP33.2, U7.28
VCC: C13.1, C14.A, J2.VIN, S2.1, U2.3
VCC1: C28.1, C29.A, J5.VIN, S4.1, U4.3
VCC2: C45.1, C46.A, J8.VIN, S6.1, U6.3
VCC3: C62.1, C63.A, J11.VIN, S8.1, U8.3
