UCSD-Quadcopter-Class/quad-hardware-connie/(commit log)

2017-04-18 added ATmega design files, parts list, jason's library
    [ATmega128RFA1-DevBoard-Panel-v23.brd, ATmega128RFA1-DevBoard.brd, ATmega128RFA1-DevBoard.sch, PartList.xlsx]
2017-04-18 updated quadcopter schematic
    [quadcopter.sch]
2017-04-18 finished, for the most part, microcontroller section
    [quadcopter.sch]
2017-04-19 Sort of finished motor driver sch
    [quadcopter.sch]
2017-04-19 added stuff
    [quadcopter.sch]
2017-04-19 added more stuff
    [quadcopter.sch]
2017-04-20 added LED library
2017-04-20 LED datasheets added
2017-04-20 tiny changes
    [quadcopter.sch]
2017-04-20 added led_notes
2017-04-20 added current-limiting resistors
    [quadcopter.sch]
2017-04-25 changes to schematic and connie lbr
    [quadcopter.sch]
2017-04-25 Corrected IMU package in connie.lbr
2017-04-25 added tPlace outline to IMU package
2017-04-27 instructior review of original schematic
2017-04-27 fixed imu cs lines and added pullup resistor
2017-04-27 Fixed most things from Professor's notes in schematic
    [quadcopter.sch]
2017-04-27 IMU is correct now I think?
    [quadcopter.sch]
2017-04-27 fixed mosfet
2017-04-28 fixed some schematic stuff
    [quadcopter.sch]
2017-04-28 made lots of semicircles
    [quadcopter.brd]
2017-04-29 Worked on board a bit, got two rough draft outlines for board?
2017-04-30 tried some stuff on board
    [quadcopter.brd, quadcopter.sch]
2017-05-01 added board stuff
    [quadcopter.brd]
2017-05-01 Restricting the Autorouter- setting trace widths - done?
    [quadcopter.brd, quadcopter.sch]
2017-05-02 did the imu protection, voltage regulator, breakout header stuff:
    [quadcopter.brd]
2017-05-02 polygons may have fallen apart
    [quadcopter.brd]
2017-05-02 no more airwires!
    [quadcopter.brd]
2017-05-04 Some changes to brd
    [ATmega128RFA1-DevBoard.brd, quadcopter.brd, quadcopter.sch]
2017-05-07 improved brd..?
    [quadcopter_2.brd, quadcopter_2.sch]
2017-05-10 fixed drc errors and routed 98%
    [quadcopter_2.brd, quadcopter_2.sch]
2017-05-10 Wired up
    [quadcopter.brd, quadcopter.sch]
2017-05-11 Tiny change
    [quadcopter.brd]
2017-05-11 Fixed stop mask errors generated by autorouter
    [quadcopter.brd]
2017-05-11 added faraday cage around antenna driver
    [quadcopter.brd]
2017-05-14 more schematic comments from swanson
2017-05-15 Some changes based on design reviews
    [quadcopter.brd, quadcopter.sch, quadcopter_2.brd, quadcopter_2.sch]
2017-05-15 fixed sch errors
    [quadcopter.brd, quadcopter.sch]
2017-05-16 Fixed board errors
    [quadcopter.brd, quadcopter.sch]
2017-05-16 Board ready for final review
    [quadcopter.brd, quadcopter.sch]
2017-05-17 Board comments from swanson
2017-05-18 Fixed new board errors
    [quadcopter.brd, quadcopter.sch]
2017-05-19 more board fixes
    [quadcopter.brd, quadcopter.sch]
