UCSD-Quadcopter-Class/quad-hardware-connie/(notices)

Notices in the files:
ATmega128RFA1_Dev-master/firmware/Arduino/hardware/sparkfun/avr/variants/rf128/pins_arduino.h:
Public License along with this library; if not, write to the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
parts and their libraries:
SparkFun-Aesthetics: Licensing: CC v3.0 Share-Alike You are welcome to use this library for commercial purposes.
SparkFun-Aesthetics: Released under the Creative Commons
